milotruck-shin/FYP/electronics/CAN bus sniffer.png

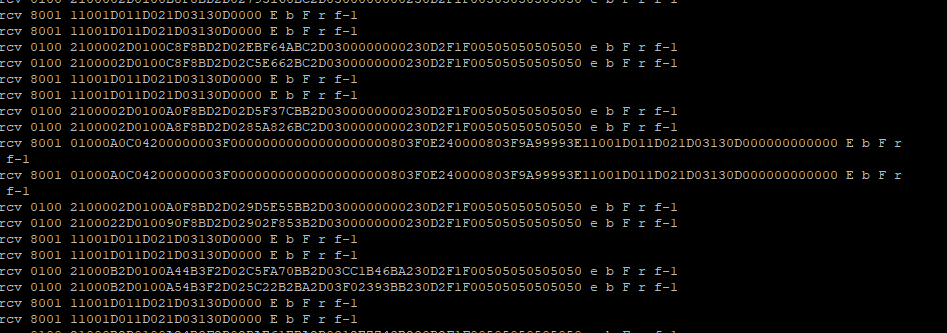
electronics/CAN bus sniffer.png
