milotruck-shin/FYP/G4/peripheral/CAN/main.c

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
/* Includes ------------------------------------------------------------------*/
#include "main.h"

FDCAN_HandleTypeDef hfdcan1;

UART_HandleTypeDef hlpuart1;
UART_HandleTypeDef huart1;

TIM_HandleTypeDef htim2;

/* USER CODE BEGIN PV */

#define RX_BUF_SIZE 64
char HLPUART1_rxBuffer[RX_BUF_SIZE];
volatile uint8_t HUART1_rxBuffer;
volatile uint8_t uart_rx_index = 0;
volatile uint8_t rx_index = 0;
volatile uint8_t command_ready = 0;
volatile uint8_t stopped = 0;
volatile uint8_t uart1_ready = 0;

uint8_t rx_data_SERIAL;
uint8_t rx_data_ESP;


float target_position;
static moteus_motor_t* motor;
uint32_t cmd_timestamp_us = 0;



/* USER CODE END PV */

void SystemClock_Config(void);
static void MX_GPIO_Init(void);
static void MX_FDCAN1_Init(void);
static void MX_LPUART1_UART_Init(void);
static void MX_USART1_UART_Init(void);
static void MX_TIM2_Init(void);
/* USER CODE BEGIN 0 */

int __io_putchar(int ch)
{
 ITM_SendChar(ch);
 return(ch);
}

int _write(int32_t file, uint8_t *ptr, int32_t len)
{
	for (int i = 0; i < len; i++)
    {
        ITM_SendChar(*ptr++);
    }
    return len;
}
/* USER CODE END 0 */

/**
  * @brief  The application entry point.
  * @retval int
  */
int main(void)
{

  /* MCU Configuration--------------------------------------------------------*/

  /* Reset of all peripherals, Initializes the Flash interface and the Systick. */
  HAL_Init();

  /* Configure the system clock */
  SystemClock_Config();

  /* Initialize all configured peripherals */
  MX_GPIO_Init();
  MX_FDCAN1_Init();
  MX_LPUART1_UART_Init();
  MX_USART1_UART_Init();
  MX_TIM2_Init();
  /* USER CODE BEGIN 2 */

  // turn on relay, PC12
  HAL_Delay(5000);
  HAL_GPIO_WritePin(GPIOC, GPIO_PIN_12, GPIO_PIN_RESET);
  // pull STBY LOW, PA9
  HAL_GPIO_WritePin(GPIOA, GPIO_PIN_9, GPIO_PIN_RESET);

  if (HAL_FDCAN_ConfigTxDelayCompensation(&hfdcan1, (hfdcan1.Init.DataPrescaler * hfdcan1.Init.DataTimeSeg1), 0U) != HAL_OK)
  {
    Error_Handler();
  }

  if (HAL_FDCAN_EnableTxDelayCompensation(&hfdcan1) != HAL_OK)
  {
    Error_Handler();
  }

  motor_init();



  moteus_position_cmd_t cmd = MOTEUS_STARTUP_SEQ_CMD;
  HAL_UART_Receive_IT(&hlpuart1,&rx_data_SERIAL,1);
  HAL_UART_Receive_IT(&huart1, (uint8_t *)&rx_data_ESP, 1);

  cmd.position = 0.0f;  // or whatever your home/default position is
  HAL_TIM_Base_Start_IT(&htim2);

  /* USER CODE END 2 */

  /* Infinite loop */
  /* USER CODE BEGIN WHILE */
  while (1)
  {
	  if (command_ready)
	  {
	      command_ready = 0;
	      char *endptr;

	      // Add this: if user sends "stop", clear fault
	      if (strncmp(HLPUART1_rxBuffer, "STOP", 4) == 0)
	      {
	    	  motor_stop();
	          stopped = 1;

	          HAL_UART_Transmit(&hlpuart1, (uint8_t*)"Motor stopped\r\n", 15, 100);
	          HAL_GPIO_WritePin(GPIOC, GPIO_PIN_12, GPIO_PIN_SET);
	      }
	      else
	      {
	          float position = strtof(HLPUART1_rxBuffer, &endptr);
	          if (endptr == HLPUART1_rxBuffer) {
	              HAL_UART_Transmit(&hlpuart1, (uint8_t*)"Invalid parameters\r\n", 20, 100);
	          } else {
		          HAL_GPIO_WritePin(GPIOC, GPIO_PIN_12, GPIO_PIN_RESET);
	              cmd.position = position;
	              stopped = 0;
	          }
	      }
	      memset(HLPUART1_rxBuffer, 0, RX_BUF_SIZE);
	  }


	  else if (uart1_ready)
	  {
		  uart1_ready = 0;
		  if (HUART1_rxBuffer == 0x01)
		  {
	          motor_stop();
	          stopped = 1;

	          HAL_UART_Transmit(&hlpuart1, (uint8_t*)"Motor stopped\r\n", 15, 100);
	          HAL_GPIO_WritePin(GPIOC, GPIO_PIN_12, GPIO_PIN_SET);
		  }
		  else if (HUART1_rxBuffer == 0x02)
		  {
	          HAL_GPIO_WritePin(GPIOC, GPIO_PIN_12, GPIO_PIN_RESET);
              cmd.position = 0.0;
              stopped = 0;
		  }
		  HUART1_rxBuffer = 0;


	  }

	  else if (!stopped) {
	      moteus_begin_position(motor, &cmd);
          cmd_timestamp_us = get_timestamp_raw() / 2;
	  }


	  HAL_Delay(1);
	  print_motor_state(cmd.position);


    /* USER CODE END WHILE */

    /* USER CODE BEGIN 3 */
  }
  /* USER CODE END 3 */
}

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
/* USER CODE BEGIN 4 */

void HAL_UART_RxCpltCallback(UART_HandleTypeDef *huart)
{
    if (huart->Instance == LPUART1)
    {

        if (rx_data_SERIAL == '\r' || rx_data_SERIAL == '\n')
        {
        	char crlf[] = "\r\n";
        	HAL_UART_Transmit(huart,(uint8_t*)crlf,2,10);
            if (rx_index > 0)
            {
            	HLPUART1_rxBuffer[rx_index] = '\0';
                command_ready = 1;
            }

            rx_index = 0;
        }
        else if (rx_index < (RX_BUF_SIZE - 1))
        {
            HAL_UART_Transmit(huart,(uint8_t*)&rx_data_SERIAL,1,10);
            HLPUART1_rxBuffer[rx_index++] = rx_data_SERIAL;
        }
        else
        {
            // Buffer overflow protection
            rx_index = 0;
        }

        HAL_UART_Receive_IT(huart, (uint8_t *)&rx_data_SERIAL, 1);

    }

	else if (huart->Instance == USART1)
		{
//			char msg [10];
//			sprintf(msg, "%02X\r\n", rx_data_ESP);
//			HAL_UART_Transmit(&hlpuart1,(uint8_t*)msg,strlen(msg),10);
			HUART1_rxBuffer = rx_data_ESP;
			uart1_ready = 1;
			HAL_UART_Receive_IT(huart, (uint8_t *)&rx_data_ESP, 1);

		}
}

void HAL_FDCAN_RxFifo0Callback(FDCAN_HandleTypeDef *hfdcan, uint32_t RxFifo0ITs)
{
    (void)RxFifo0ITs;
    moteus_fdcan_rx_callback(hfdcan);

}

void print_motor_state(float command_motor_position)
{
	const moteus_result_t* r = moteus_set_query(motor);

    if (r) {
        printf("%" PRIu32"us,%s, %.3f rev, %.3f rev, %.3f rev/s, %.3f Nm, %.1f V, %.1f C, %.1f A, %.1f A\r\n", \
        		cmd_timestamp_us,moteus_mode_str(r->mode),command_motor_position, r->position, r->velocity ,r->torque,r->voltage,r->temperature, r->q_current, r->d_current );
//        printf("Mode: %s\r\n", moteus_mode_str(r->mode));
//        printf("Position: %.3f rev\r\n", r->position);
//        printf("Velocity: %.3f rev/s\r\n", r->velocity);
//        printf("Torque: %.3f Nm\r\n", r->torque);
//        printf("Voltage: %.1f V\r\n", r->voltage);
//        printf("Temperature: %.1f C\r\n", r->temperature);

        if (r->fault != MOTEUS_FAULT_NONE) {
            printf("FAULT: %s\r\n", moteus_fault_str(r->fault));
        }
    } else {
        printf("Query failed: %s\r\n", moteus_error_str(motor->last_error));
    }
}

void motor_init(void)
{
    // Initialize CAN peripheral
    moteus_can_init(&hfdcan1);

    // Create motor instance (ID 1)
    motor = moteus_init(&hfdcan1, 2);
    if (!motor) {
    	char failed_msg[]="Failed to initialize motor\r\n";
    	HAL_UART_Transmit(&hlpuart1,(uint8_t*)failed_msg,sizeof(failed_msg),10);
        return;
    }

    else
    {
    	char sucess_msg[]="Motor Initialised!\r\n";
    	HAL_UART_Transmit(&hlpuart1,(uint8_t*)sucess_msg,sizeof(sucess_msg),10);
    }

    // Optional: reduce timeout for faster failure detection
    motor->timeout_ms = 50;
}

void motor_stop(void)
{
    const moteus_result_t* r = moteus_set_stop(motor);
    if (r) {
        printf("Motor stopped.\n");
    }
}


//void print_motor_state(void)
//{
//    char buf[64];
//    int len;
//    const moteus_result_t* r = moteus_set_query(motor);
//
//    if (r) {
//        len = snprintf(buf, sizeof(buf), "Mode: %s\r\n", moteus_mode_str(r->mode));
//        HAL_UART_Transmit(&hlpuart1, (uint8_t*)buf, len, HAL_MAX_DELAY);
//
//        len = snprintf(buf, sizeof(buf), "Position: %.3f rev\r\n", r->position);
//        HAL_UART_Transmit(&hlpuart1, (uint8_t*)buf, len, HAL_MAX_DELAY);
//
//        len = snprintf(buf, sizeof(buf), "Velocity: %.3f rev/s\r\n", r->velocity);
//        HAL_UART_Transmit(&hlpuart1, (uint8_t*)buf, len, HAL_MAX_DELAY);
//
//        len = snprintf(buf, sizeof(buf), "Torque: %.3f Nm\r\n", r->torque);
//        HAL_UART_Transmit(&hlpuart1, (uint8_t*)buf, len, HAL_MAX_DELAY);
//
//        len = snprintf(buf, sizeof(buf), "Voltage: %.1f V\r\n", r->voltage);
//        HAL_UART_Transmit(&hlpuart1, (uint8_t*)buf, len, HAL_MAX_DELAY);
//
//        len = snprintf(buf, sizeof(buf), "Temperature: %.1f C\r\n", r->temperature);
//        HAL_UART_Transmit(&hlpuart1, (uint8_t*)buf, len, HAL_MAX_DELAY);
//
//        if (r->fault != MOTEUS_FAULT_NONE) {
//            len = snprintf(buf, sizeof(buf), "FAULT: %s\r\n", moteus_fault_str(r->fault));
//            HAL_UART_Transmit(&hlpuart1, (uint8_t*)buf, len, HAL_MAX_DELAY);
//        }
//    } else {
//        len = snprintf(buf, sizeof(buf), "Query failed: %s\r\n", moteus_error_str(motor->last_error));
//        HAL_UART_Transmit(&hlpuart1, (uint8_t*)buf, len, HAL_MAX_DELAY);
//    }
//}


/* USER CODE END 4 */
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
