milotruck-shin/FYP/G4/peripheral/CAN/CAN.ioc

Mcu.UserName=STM32G474RETx
PA10.Signal=USART1_RX
PA11.Signal=FDCAN1_RX
PA12.Signal=FDCAN1_TX
PA13.Signal=SYS_JTMS-SWDIO
PA14.Signal=SYS_JTCK-SWCLK
PA2.Signal=LPUART1_TX
PA3.Signal=LPUART1_RX
PA9.Signal=GPIO_Output
PB3.Signal=SYS_JTDO-SWO
PC12.Signal=GPIO_Output
PC4.Signal=USART1_TX
PF0-OSC_IN.Signal=RCC_OSC_IN
PF1-OSC_OUT.Signal=RCC_OSC_OUT
