milotruck-shin/FYP/FYP_G4/main.h

#define DEFAULT_POS 50
#define GEAR_RATIO 1.5 // 40 teeth upper pulley. 60 teeth lower pulley
#define MOTEUS_POSITION_JMP_CMD { \
#define MOTEUS_STARTUP_SEQ_CMD { \
#define AP_EVENT   (1 << 0)		//event flag for air pressure, will trigger once the UART receive INT is triggered
#define POS_EVENT   (1 << 1)	//event flag for jump event
#define PNEU_EVENT   (1 << 2)	//event flag for pneumatic cylinder release
