milotruck-shin/FYP/(commit log)

2026-05-20 bug fixes on implicit declaration,const pointer changes, Kp Kd changes
    [main.c, main.h]
2026-07-15 ESP32 and BT communication src
