milotruck-shin/FYP/(notices)

Notices in the files:
G4/peripheral/CAN/main.c:
Copyright (c) 2026 STMicroelectronics.
All rights reserved.
This software is licensed under terms that can be found in the LICENSE file
